MaksimKondratovich/Mini-power/mini-power/mini-power.kicad_pcb

## KiCad design mini-power/mini-power.kicad_pcb (2026-10-04)

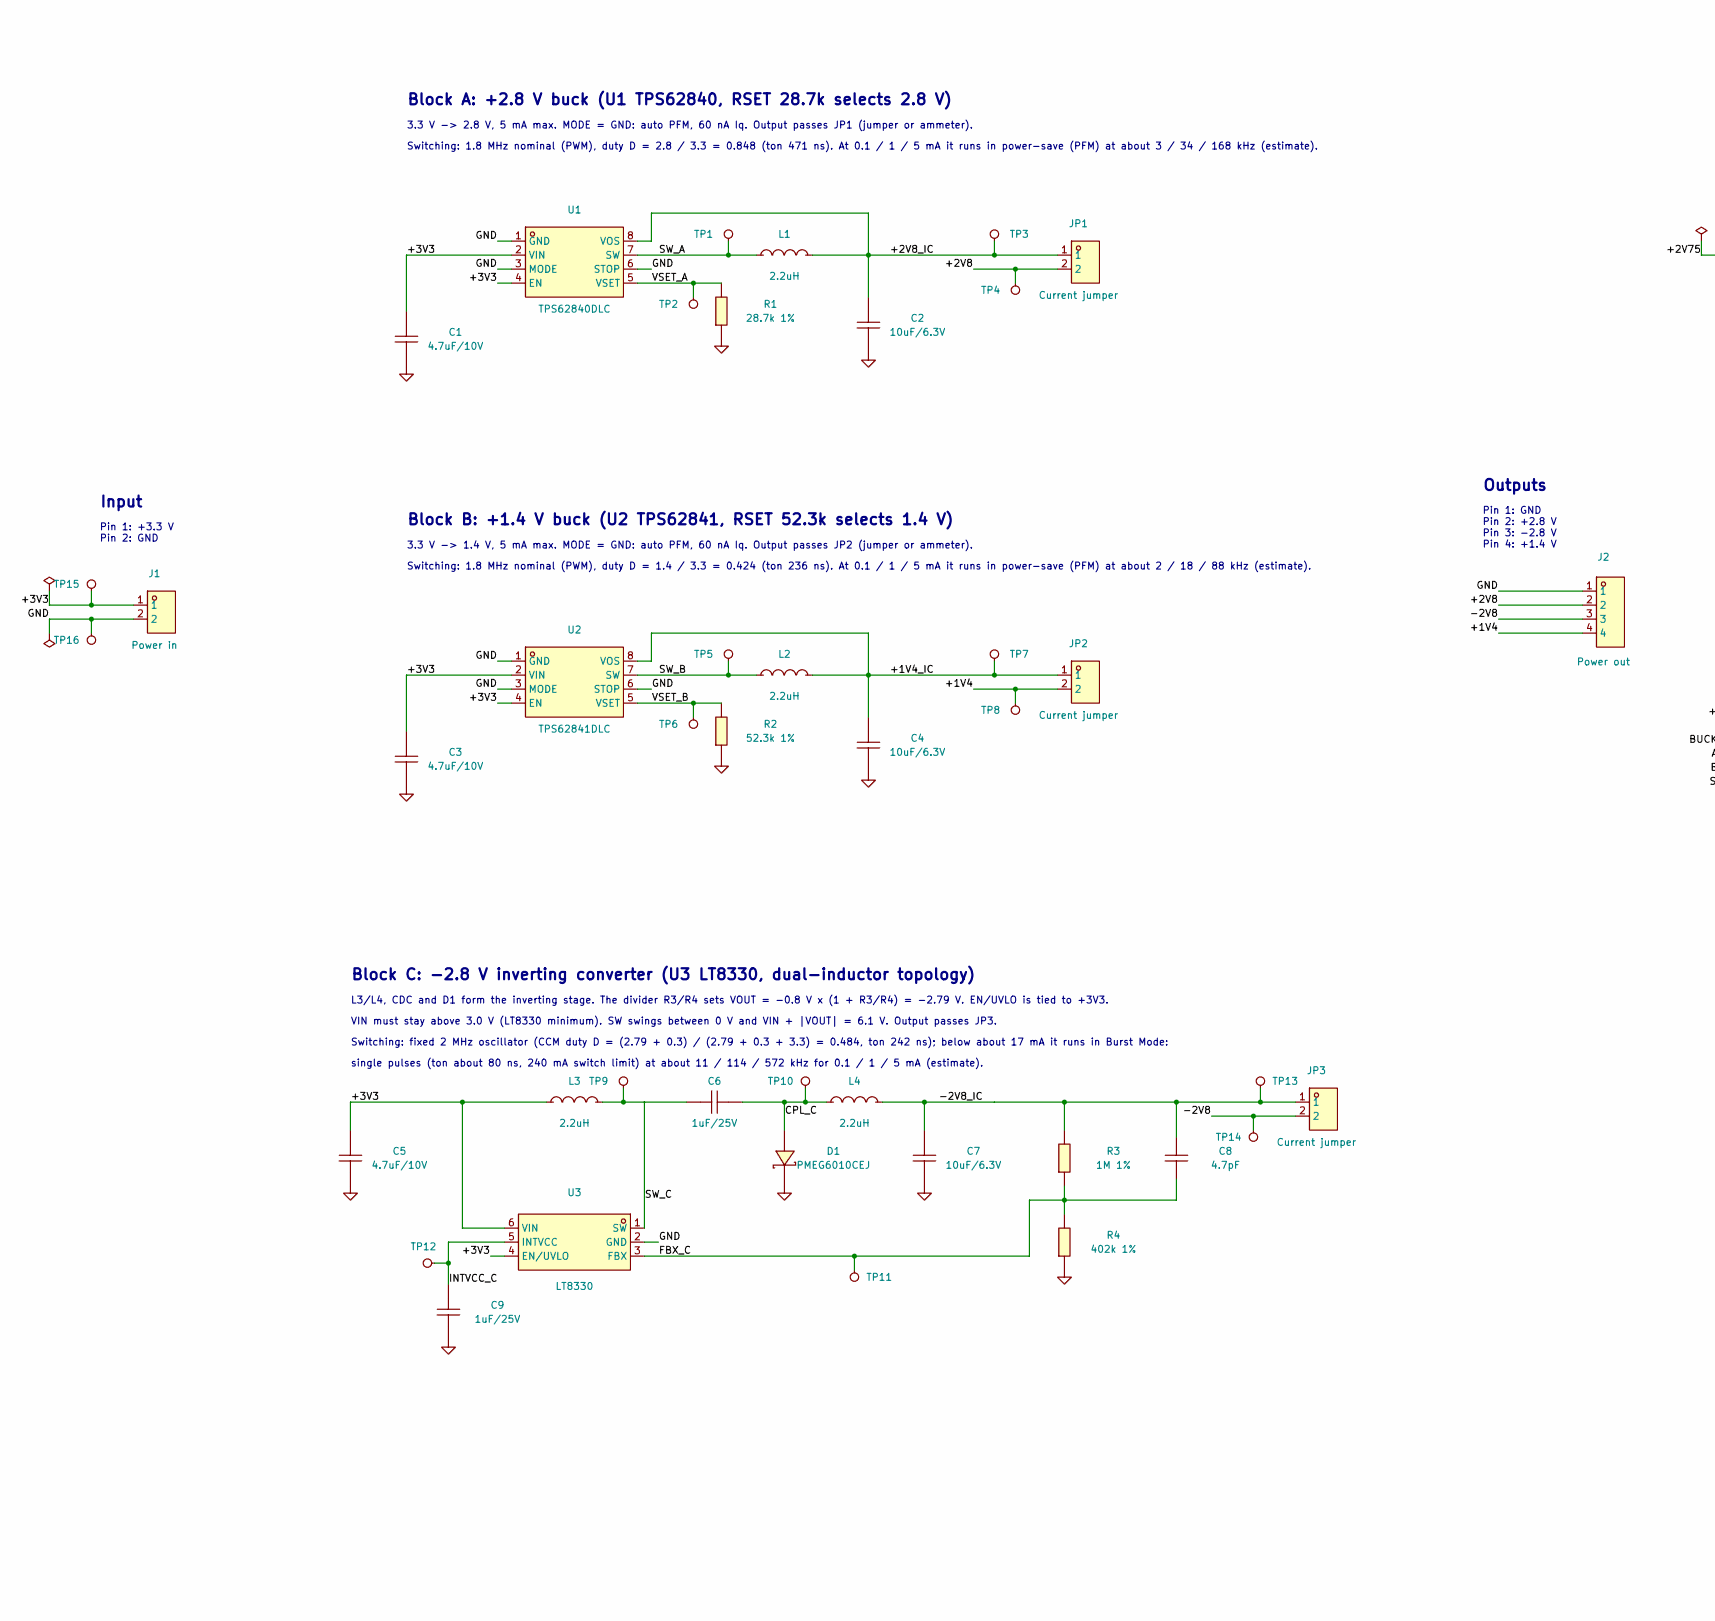
[picture p1: schematic mini-power.kicad_sch, part in row 1, column 1]

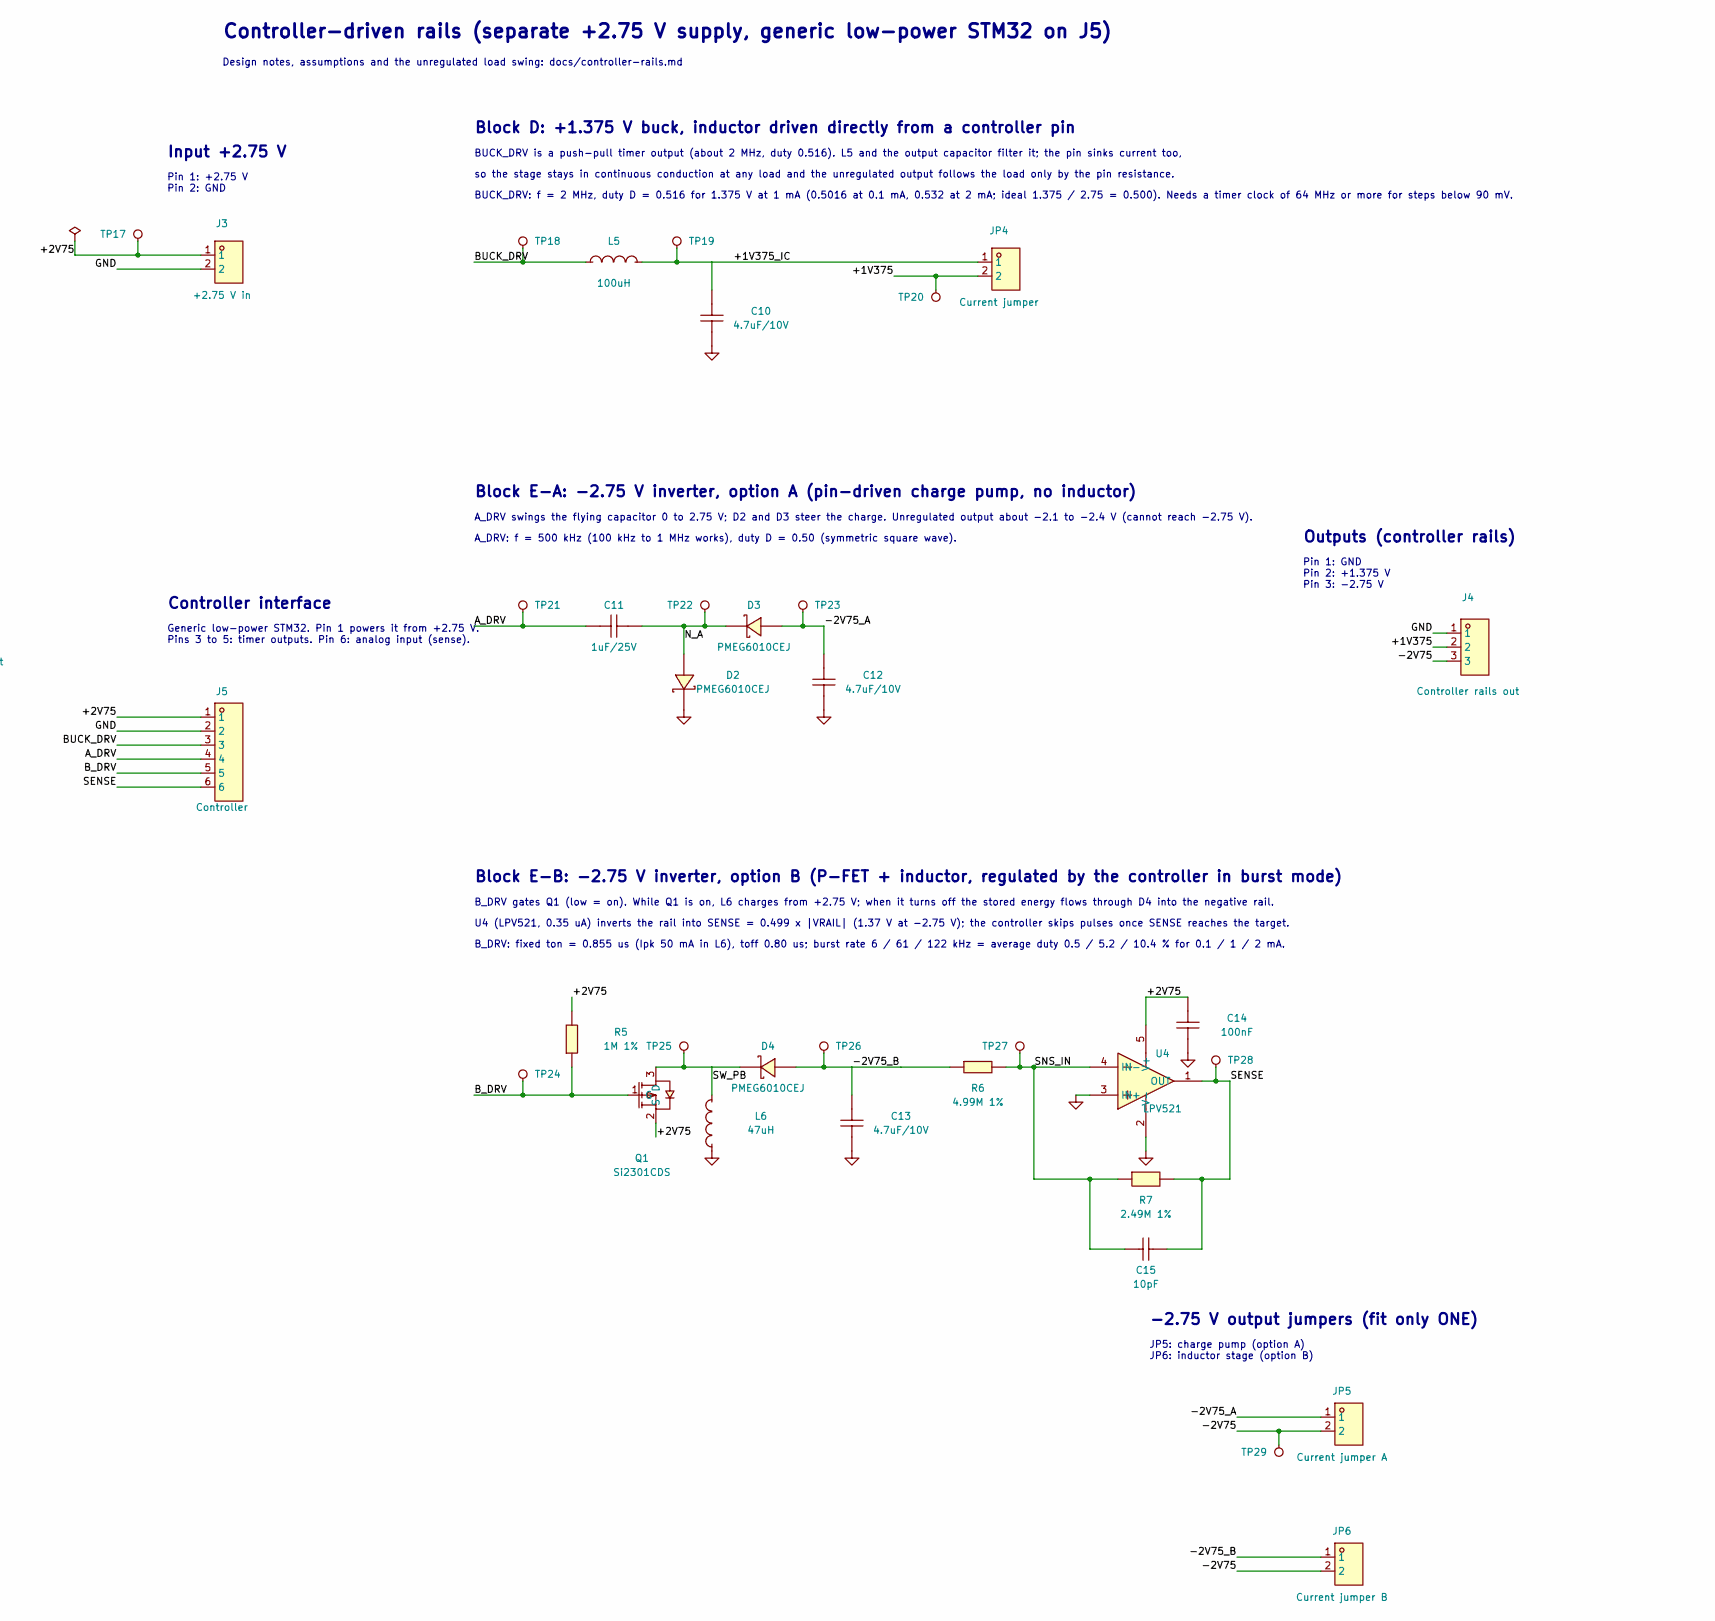
[picture p2: schematic mini-power.kicad_sch, part in row 1, column 2]

Parts:
C1, C3, C5, C10, C12, C13: 4.7uF/10V; C0402; MPN CL05A475MP5NRNC; LCSC Part C23733
C2, C4, C7: 10uF/6.3V; C0402; MPN CGA0402X5R106M6R3GT; LCSC Part C23692971
C6, C9, C11: 1uF/25V; C0402; MPN CL05A105KA5NQNC; LCSC Part C52923
C8: 4.7pF; C0402; MPN 0402CG4R7C500NT; LCSC Part C1569
C14: 100nF; C0402; MPN CL05B104KO5NNNC; LCSC Part C1525
C15: 10pF; C0402; MPN CC0402JRNPO9BN100; LCSC Part C106199
D1, D2, D3, D4: PMEG6010CEJ; SOD-323F_L2.0-W1.6-LS2.5-RD; MPN PMEG6010CEJ,115; LCSC Part C406049
J1: Power in; HDR-TH_2P-P2.54-V-M; MPN PZ254V-11-02P; LCSC Part C492401
J2: Power out; HDR-TH_4P-P2.54-V-M; MPN PZ254V-11-04P; LCSC Part C2691448
J3: +2.75 V in; HDR-TH_2P-P2.54-V-M; MPN PZ254V-11-02P; LCSC Part C492401
J4: Controller rails out; HDR-TH_3P-P2.54-V-M_PZ254V-11-03P; MPN PZ254V-11-03P; LCSC Part C2937625
J5: Controller; HDR-TH_6P-P2.54-V-M; MPN PZ254V-11-06P; LCSC Part C492405
JP1, JP2, JP3, JP4: Current jumper; HDR-TH_2P-P2.54-V-M; MPN PZ254V-11-02P; LCSC Part C492401
JP5: Current jumper A; HDR-TH_2P-P2.54-V-M; MPN PZ254V-11-02P; LCSC Part C492401
JP6: Current jumper B; HDR-TH_2P-P2.54-V-M; MPN PZ254V-11-02P; LCSC Part C492401
L1, L2, L3, L4: 2.2uH; L0806; MPN DFE201612E-2R2M=P2; LCSC Part C337893
L5: 100uH; L0805; MPN LBR2012T101M; LCSC Part C223273
L6: 47uH; L0805; MPN LB2012T470M; LCSC Part C223254
Q1: Si2301CDS; SOT-23-3_L3.0-W1.7-P0.95-LS2.9-BR; MPN SI2301CDS-T1-GE3; LCSC Part C10487
R1: 28.7k 1%; R0402; MPN 0402WGF2872TCE; LCSC Part C26972
R2: 52.3k 1%; R0402; MPN 0402WGF5232TCE; LCSC Part C26982
R3, R5: 1M 1%; R0402; MPN 0402WGF1004TCE; LCSC Part C26083
R4: 402k 1%; R0402; MPN 0402WGF4023TCE; LCSC Part C25785
R6: 4.99M 1%; R0402; MPN RC0402FR-074M99L; LCSC Part C137963
R7: 2.49M 1%; R0402; MPN FRC0402F2494TS; LCSC Part C5159683
TP1: SW_A; TestPoint_0.5mm
TP2: VSET_A; TestPoint_0.5mm
TP3: +2V8_IC; TestPoint_0.5mm
TP4: +2V8; TestPoint_0.5mm
TP5: SW_B; TestPoint_0.5mm
TP6: VSET_B; TestPoint_0.5mm
TP7: +1V4_IC; TestPoint_0.5mm
TP8: +1V4; TestPoint_0.5mm
TP9: SW_C; TestPoint_0.5mm
TP10: CPL_C; TestPoint_0.5mm
TP11: FBX_C; TestPoint_0.5mm
TP12: INTVCC_C; TestPoint_0.5mm
TP13: -2V8_IC; TestPoint_0.5mm
TP14: -2V8; TestPoint_0.5mm
TP15: +3V3; TestPoint_0.5mm
TP16: GND; TestPoint_0.5mm
TP17: +2V75; TestPoint_0.5mm
TP18: BUCK_DRV; TestPoint_0.5mm
TP19: +1V375_IC; TestPoint_0.5mm
TP20: +1V375; TestPoint_0.5mm
TP21: A_DRV; TestPoint_0.5mm
TP22: N_A; TestPoint_0.5mm
TP23: -2V75_A; TestPoint_0.5mm
TP24: B_DRV; TestPoint_0.5mm
TP25: SW_PB; TestPoint_0.5mm
TP26: -2V75_B; TestPoint_0.5mm
TP27: SNS_IN; TestPoint_0.5mm
TP28: SENSE; TestPoint_0.5mm
TP29: -2V75; TestPoint_0.5mm
U1: TPS62840DLC; VSON-8_L2.0-W1.5-P0.50-BL; MPN TPS62840DLCR; LCSC Part C2071859
U2: TPS62841DLC; VSON-8_L2.0-W1.5-P0.50-BL; MPN TPS62841DLCR; LCSC Part C2860681
U3: LT8330; SOT-23-6_L2.9-W1.6-P0.95-LS2.8-BR; MPN LT8330ES6#TRMPBF; LCSC Part C580285
U4: LPV521; SC-70-5_L2.0-W1.3-P0.65-LS2.2-BL; MPN LPV521MGX/NOPB; LCSC Part C779403

Connections:
/+1V4: J2.4, JP2.2, TP8.1
/+1V4_IC: C4.2, JP2.1, L2.2, TP7.1, U2.8 (VOS)
/+1V375: J4.2, JP4.2, TP20.1
/+1V375_IC: C10.2, JP4.1, L5.2, TP19.1
/+2V8: J2.2, JP1.2, TP4.1
/+2V8_IC: C2.2, JP1.1, L1.2, TP3.1, U1.8 (VOS)
/+2V75: C14.2, J3.1, J5.1, Q1.2 (S), R5.2, TP17.1, U4.5 (V+)
/+3V3: C1.2, C3.2, C5.2, J1.1, L3.1, TP15.1, U1.2 (VIN), U1.4 (EN), U2.2 (VIN), U2.4 (EN), U3.4 (EN/UVLO), U3.6 (VIN)
/-2V8: J2.3, JP3.2, TP14.1
/-2V8_IC: C7.2, C8.2, JP3.1, L4.2, R3.2, TP13.1
/-2V75: J4.3, JP5.2, JP6.2, TP29.1
/-2V75_A: C12.2, D3.2 (A), JP5.1, TP23.1
/-2V75_B: C13.2, D4.2 (A), JP6.1, R6.1, TP26.1
/A_DRV: C11.1, J5.4, TP21.1
/BUCK_DRV: J5.3, L5.1, TP18.1
/B_DRV: J5.5, Q1.1 (G), R5.1, TP24.1
/CPL_C: C6.2, D1.2 (A), L4.1, TP10.1
/FBX_C: C8.1, R3.1, R4.2, TP11.1, U3.3 (FBX)
/INTVCC_C: C9.2, TP12.1, U3.5 (INTVCC)
/N_A: C11.2, D2.2 (A), D3.1 (C), TP22.1
/SENSE: C15.2, J5.6, R7.2, TP28.1, U4.1 (OUT)
/SNS_IN: C15.1, R6.2, R7.1, TP27.1, U4.4 (IN-)
/SW_A: L1.1, TP1.1, U1.7 (SW)
/SW_B: L2.1, TP5.1, U2.7 (SW)
/SW_C: C6.1, L3.2, TP9.1, U3.1 (SW)
/SW_PB: D4.1 (C), L6.2, Q1.3 (D), TP25.1
/VSET_A: R1.2, TP2.1, U1.5 (VSET)
/VSET_B: R2.2, TP6.1, U2.5 (VSET)
GND: C1.1, C2.1, C3.1, C4.1, C5.1, C7.1, C9.1, C10.1, C12.1, C13.1, C14.1, D1.1 (C), D2.1 (C), J1.2, J2.1, J3.2, J4.1, J5.2, L6.1, R1.1, R2.1, R4.1, TP16.1, U1.1 (GND), U1.3 (MODE), U1.6 (STOP), U2.1 (GND), U2.3 (MODE), U2.6 (STOP), U3.2 (GND), U4.2 (V-), U4.3 (IN+)

Notes on the sheet:
Block A: +2.8 V buck (U1 TPS62840, RSET 28.7k selects 2.8 V)
3.3 V -> 2.8 V, 5 mA max. MODE = GND: auto PFM, 60 nA Iq. Output passes JP1 (jumper or ammeter).
Switching: 1.8 MHz nominal (PWM), duty D = 2.8 / 3.3 = 0.848 (ton 471 ns). At 0.1 / 1 / 5 mA it runs in power-save (PFM) at about 3 / 34 / 168 kHz (estimate).
Block B: +1.4 V buck (U2 TPS62841, RSET 52.3k selects 1.4 V)
3.3 V -> 1.4 V, 5 mA max. MODE = GND: auto PFM, 60 nA Iq. Output passes JP2 (jumper or ammeter).
Switching: 1.8 MHz nominal (PWM), duty D = 1.4 / 3.3 = 0.424 (ton 236 ns). At 0.1 / 1 / 5 mA it runs in power-save (PFM) at about 2 / 18 / 88 kHz (estimate).
Block C: -2.8 V inverting converter (U3 LT8330, dual-inductor topology)
L3/L4, CDC and D1 form the inverting stage. The divider R3/R4 sets VOUT = -0.8 V x (1 + R3/R4) = -2.79 V. EN/UVLO is tied to +3V3.
VIN must stay above 3.0 V (LT8330 minimum). SW swings between 0 V and VIN + |VOUT| = 6.1 V. Output passes JP3.
Switching: fixed 2 MHz oscillator (CCM duty D = (2.79 + 0.3) / (2.79 + 0.3 + 3.3) = 0.484, ton 242 ns); below about 17 mA it runs in Burst Mode:
single pulses (ton about 80 ns, 240 mA switch limit) at about 11 / 114 / 572 kHz for 0.1 / 1 / 5 mA (estimate).
Input
Pin 1: +3.3 V Pin 2: GND
Outputs
Pin 1: GND Pin 2: +2.8 V Pin 3: -2.8 V Pin 4: +1.4 V
Controller-driven rails (separate +2.75 V supply, generic low-power STM32 on J5)
Design notes, assumptions and the unregulated load swing: docs/controller-rails.md
Input +2.75 V
Pin 1: +2.75 V Pin 2: GND
Controller interface
Generic low-power STM32. Pin 1 powers it from +2.75 V. Pins 3 to 5: timer outputs. Pin 6: analog input (sense).
Block D: +1.375 V buck, inductor driven directly from a controller pin
BUCK_DRV is a push-pull timer output (about 2 MHz, duty 0.516). L5 and the output capacitor filter it; the pin sinks current too,
so the stage stays in continuous conduction at any load and the unregulated output follows the load only by the pin resistance.
BUCK_DRV: f = 2 MHz, duty D = 0.516 for 1.375 V at 1 mA (0.5016 at 0.1 mA, 0.532 at 2 mA; ideal 1.375 / 2.75 = 0.500). Needs a timer clock of 64 MHz or more for steps below 90 mV.
Block E-A: -2.75 V inverter, option A (pin-driven charge pump, no inductor)
A_DRV swings the flying capacitor 0 to 2.75 V; D2 and D3 steer the charge. Unregulated output about -2.1 to -2.4 V (cannot reach -2.75 V).
A_DRV: f = 500 kHz (100 kHz to 1 MHz works), duty D = 0.50 (symmetric square wave).
Block E-B: -2.75 V inverter, option B (P-FET + inductor, regulated by the controller in burst mode)
B_DRV gates Q1 (low = on). While Q1 is on, L6 charges from +2.75 V; when it turns off the stored energy flows through D4 into the negative rail.
U4 (LPV521, 0.35 uA) inverts the rail into SENSE = 0.499 x |VRAIL| (1.37 V at -2.75 V); the controller skips pulses once SENSE reaches the target.
B_DRV: fixed ton = 0.855 us (Ipk 50 mA in L6), toff 0.80 us; burst rate 6 / 61 / 122 kHz = average duty 0.5 / 5.2 / 10.4 % for 0.1 / 1 / 2 mA.
-2.75 V output jumpers (fit only ONE)
JP5: charge pump (option A) JP6: inductor stage (option B)
Outputs (controller rails)
Pin 1: GND Pin 2: +1.375 V Pin 3: -2.75 V

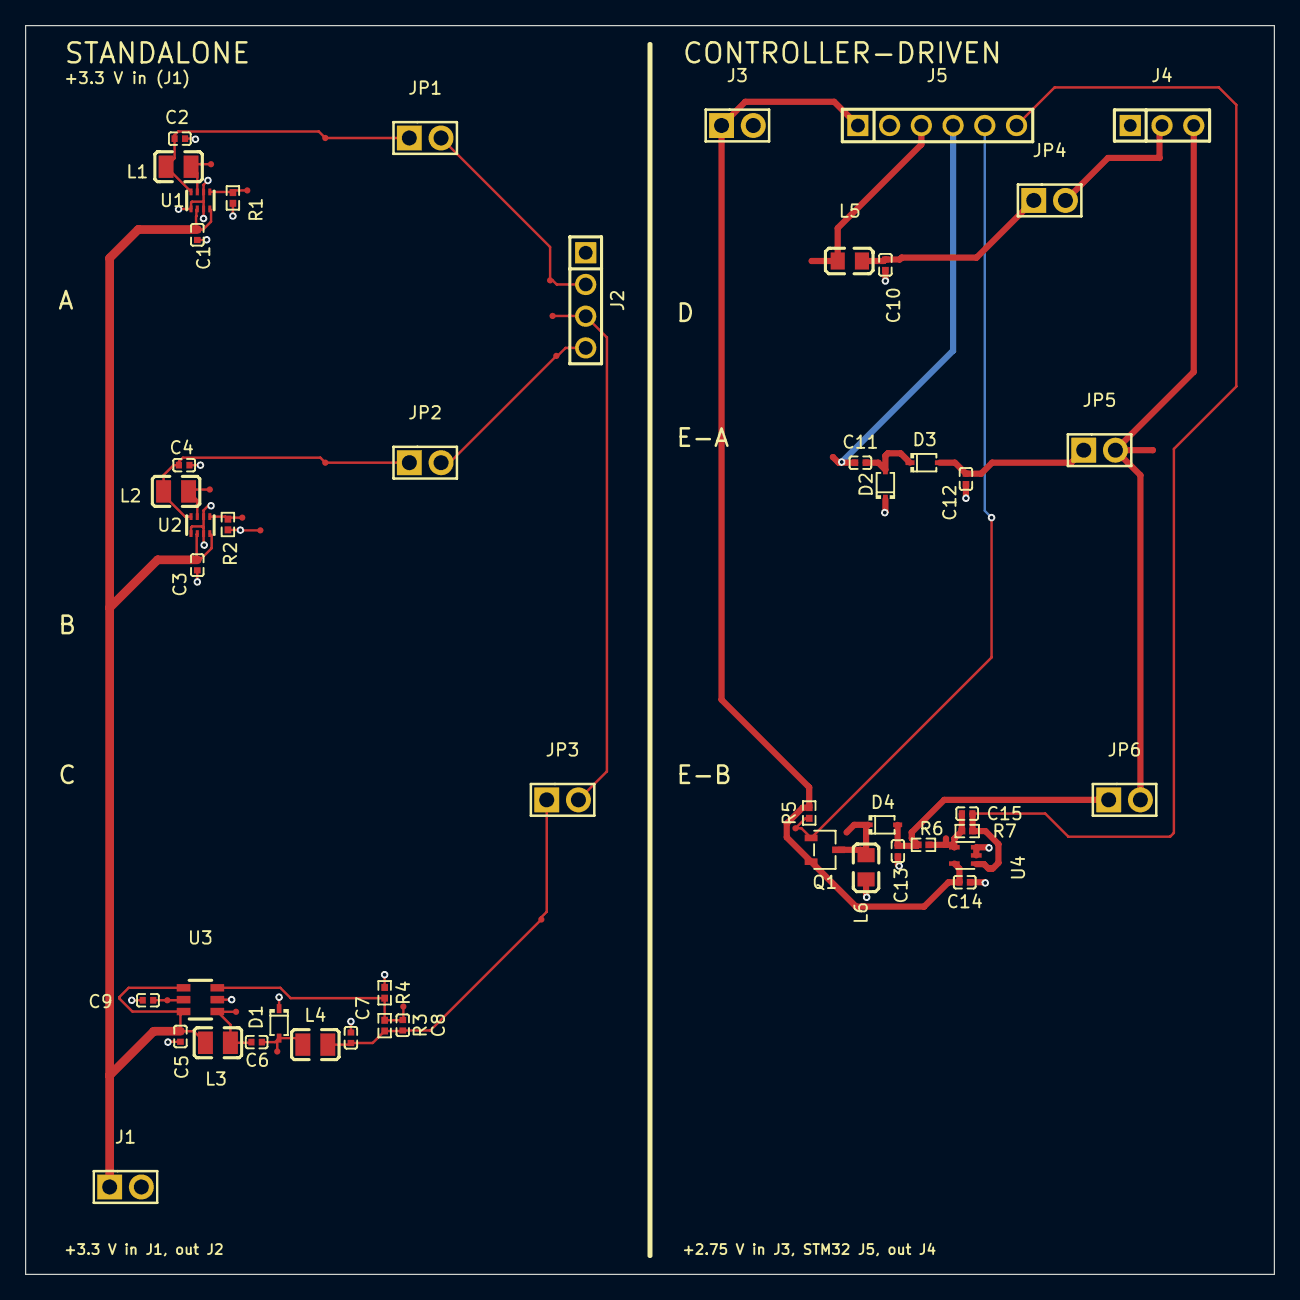
[picture p3: board mini-power.kicad_pcb from above]

Board: 2 copper layers, 100.0 x 100.0 mm, 77 parts (0 on the bottom side), 29 nets.
