MaksimKondratovich/Mini-power/(commit log)

2026-10-03 Kicad project init
2026-10-03 Add power supply schematic, parts libraries and design docs
    - Schematic (A2, generated by tools/gen_schematic.py): +2.8 V and +1.4 V
    TPS6284x bucks, -2.8 V LT8330 inverter, and controller-driven +1.375 V
    buck and -2.75 V inverter options (charge pump / P-FET + inductor) with
    an LPV521 sense amplifier, series current jumpers and one test point per net
    - LCSC parts imported with easyeda2kicad into mini-power/lib
    - Design notes and calculations in docs/, project rules in CLAUDE.md
2026-10-03 Add generated PCB with separated standalone and controller sections
    - 100 x 100 mm, 2 layers, bottom GND pour; DRC with schematic parity clean
    - STANDALONE (+3.3 V) on the left, CONTROLLER-DRIVEN (+2.75 V, STM32 on J5)
    on the right, divided at x = 50 mm; only the GND plane is shared
    - One 0.5 mm test point per net; rules 0.10 mm / 0.15 mm / 0.5-0.3 mm vias
    - Generator scripts (place, route, finish, render) and docs/pcb.md
    - Footprint library: pin-1 dots moved from silkscreen to the fab layer
2026-10-03 Add switching frequency and duty cycle for all converters
    - Schematic notes under every block: TPS62840/41 and LT8330 (integrated)
    and the three controller-driven stages (pin buck, charge pump, P-FET stage)
    - docs/power-architecture.md section 8 and docs/controller-rails.md section 8.4
    - tools/integrated_rails_model.py reproduces the integrated-rail estimates
2026-10-04 Corrected PCB layout
